ianm8/iqSDR40/README.md

# iqSDR40
A small software defined transceiver for 40M using the phasing method of image rejection.

### Features
* Pi Pico 2 (RP2350)
* TCXO frequency stability
* PCM1808 24 bit ADC
* Direct conversion quadrature phasing image rejection
* Floating point DSP
* LSB, USB and CW
* 30 KHz spectrum display
* Effective AGC and S meter
* Mostly 1206 SM parts
* 100mm X 80mm PCB

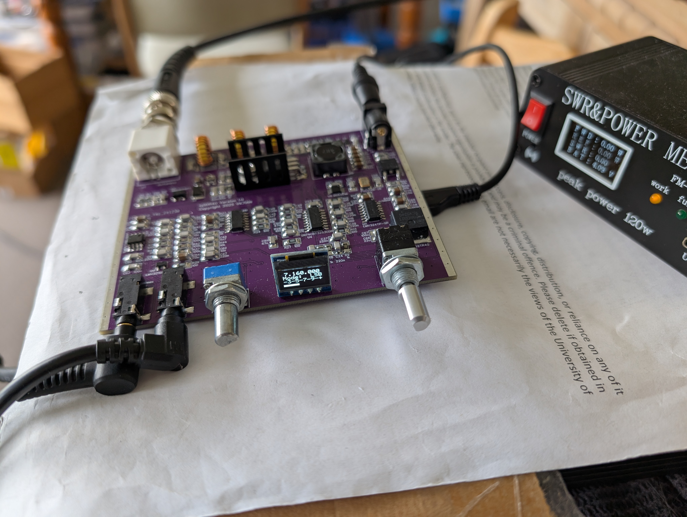
[picture p1: docs/iqSDR40-Complete-1.jpg]
