ianm8/iqSDR40/src/README.md

 ## Build
 *  Board: Pi Pico 2
 *  Flash 4MB (Sketch: 4032KB, FS: 64KB)
 *  CPU Speed: 240Mhz
 *  Optimize: -O3
 *  USB Stack: No USB

## Some history
 * Version 0.9.240 code cleanup
 * Version 1.0.240 CW paddle support and bug fixes
 * Version 1.1.240 bug fixes
 * Version 1.2.240 delay mic level to settle
 * Version 1.3.240 update filters
 * Version 2.0.240 CESSB
 * Version 2.1.240 mic gain
 * Version 2.2.240 RX bandwidth
 * Version 2.3.240 remove spectrum hack
 * Version 2.4.240 TX bandwidth
