ianm8/iqSDR40/docs/BOM_iqSDR40_2025-04-01.csv

ID | Name | Designator | Footprint | Quantity | Manufacturer Part | Manufacturer | Supplier | Supplier Part
1 | 330p | C1,C3,C8,C21 | 1206 | 4
2 | 220p | C2 | 1206 | 1
3 | 100p | C4 | 1206 | 1
4 | 510p | C5,C44,C45 | 1206 | 3
5 | 820p | C6,C7,C53 | 1206 | 3
6 | 100n | C9,C15,C17,C18,C20,C22,C23,C28,C30,C32,C34,C58,C60,C63,C64,C67,C68,C71,C72 | 1206 | 19
7 | 22u | C10,C11,C12,C13,C14,C16,C29,C31,C33,C35,C46,C54,C65,C66,C69,C70 | 1206 | 16
8 | 10n | C19,C26,C27,C49,C50,C51,C52,C57,C59,C62,C73 | 1206 | 11
9 | 220n | C24,C25,C36,C37,C38,C39,C47,C48,C56,C61 | 1206 | 10
10 | 47n | C40,C41,C42,C43,C55 | 1206 | 5
11 | 1N4148W-7-F | D1,D2 | SOD-123_L2.8-W1.8-LS3.7-RD | 2 | 1N4148W-7-F |  | Mouser
12 | SS14 | D3 | SMA_L4.4-W2.8-LS5.4-RD | 1 | SS14 | MDD | Mouser
13 | Antenna | J1 | BNC_PCB | 1 | 73137-5015 | Molex | Mouser | 538-73137-5015
14 | Mic | J2 | CUI_SJ-3524-SMT | 1 |  |  |  | SJ-3524-SMT
15 | Phones | J3 | CUI_SJ-3524-SMT | 1 |  |  | Mouser | SJ-3524-SMT
16 | Power | J4 | DC-072-165A | 1 | PJ-002AH | Same Sky | Mouser
17 | OLED-SSD1306 | J5 | HDR-M-2.54_1X4 | 1
18 | 1u2 | L1,L2,L3 | T37-6 | 3
19 | 1u | L4,L5 | 120608 | 2 | MCQ1V3216-1R0-R | Eaton Electronics | Mouser | 704-MCQ1V3216-1R0-R
20 | PFL4514-153MEC | L6 | PFL4514-SM | 1 | PFL4514 | Coilcraft |  | PFL4514
21 | PZT2222 | Q1 | SOT-223_L6.5-W3.5-P2.30-LS7.0-BR | 1 | PZT2222AT1G | ON Semicon | Mouser
22 | RD16HHF1 | Q2 | TO220 | 1 | RD16HHF1 |  |  | Heatsink: 567-274-2AB
23 | FQD11P06TM | Q3 | DPAK-3_L6.6-W6.1-P2.28-LS9.9-BR | 1 | FQD11P06TM | ON Semiconductor | Mouser
24 | 1k | R1,R2,R8,R9,R16,R17,R18,R19,R30,R31,R34,R36 | 1206 | 12 | ?
25 | 10k | R3,R21,R22,R44,R45,R50,R51 | 1206 | 7 | ?
26 | 100 | R4,R5,R7,R10,R12,R13,R14,R15,R23,R24,R25,R26,R27,R28,R29 | 1206 | 15 | ?
27 | 10 | R6,R11,R20 | 1206 | 3 | ?
28 | 100k | R32,R35,R37,R39,R41,R42 | 1206 | 6 | ?
29 | 2k | R33,R38,R40,R43,R46,R47,R48 | 1206 | 7 | ?
30 | 10/500mW | R49 | 1206 | 1 | ? |  |  | 352210RJT
31 | PEC09-SWITCH-T | SW1 | PEC09-SWITCH-T | 1 | PEC09-2315K-T0015 or PEC09-2320F-T0015 | Bourns | Digi-Key | 118-PEC09-2315K-T0015-ND
32 | SRF1260-4R7Y | T1 | SRF1260-4R7Y | 1 | SRF1260-4R7Y | Bourns | Mouser | 652-SRF1260-4R7Y
33 | PA4339.501 | T2 | PA4339.501NLT FOOTPRINT | 1 | PA4339.501NLT | Pulse Electronics Power | Mouser | PA4339.501NLT
34 | TLS850B0TE V50 | U1 | PG-TO252-5_L6.5-W6.3-P1.14-LS10.0-BR | 1 | TLS850B0TE V50 | Infineon(英飞凌) | Mouser
35 | MMG3H21NT1 | U2 | SOT-89-3_L4.5-W2.5-P1.50-LS4.2-BR | 1 | MMG3H21NT1 | NXP | Mouser
36 | PCM1808PW | U3 | TSSOP-14_L5.0-W4.4-P0.65-LS6.4-BL | 1 | PCM1808PW | TI(德州仪器) | Mouser
37 | SN74CBT3253CDR | U4 | SOIC-16_L9.9-W3.9-P1.27-LS6.0-BL | 1 | SN74CBT3253PWR | Texas Instruments | Mouser
38 | MS5351M | U5 | MSOP-10_L3.0-W3.0-P0.50-LS5.0-BL | 1 | MS5351M | 杭州瑞盟 | LCSC | C1509083
39 | FOX914B-26 | U6 | FOX924B | 1 | FOX924B-25 | Fox | Mouser | 559-FOX924B-25
40 | LMV321SN3T1G | U9 | TSOP-5_L3.0-W1.5-P0.95-BL | 1 | LMV321SN3T1G |  | Mouser
41 | LM4875MX/NOPB | U10 | SOIC-8 | 1 | LM4875MX/NOPB | TI | Mouser
42 | Raspberry Pi Pico 2 Castellated | U11 | PI_PICO_RP2040 | 1 | Pi Pico 2 | Raspberry Pi Foundation | Raspberry Pi | Pi Pico 2
43 | MC7805CD2TR4G | U12 | TO-263-2_L10.0-W9.1-P5.08-LS15.2-TL | 1 | MC7805CD2TR4G | onsemi | Mouser | 863-MC7805CD2TR4G
44 | 1k | VR1 | 35WR1KLFTR | 1 |  |  |  | 35WR1KLFTR
45 | 10k | VR2 | BOURNS_PTD901_1GANG | 1 | PTD901-1015K-B103‎ | Bourns | Mouser | PTD901-1015K-B103‎
46 | LMV324TP-SR | U7 | SOIC-14_L8.7-W3.9-P1.27-LS6.0-BL | 1 | 3PEAK | LMV324TP-SR | Mouser | C90298
47 | TL974ID | U8 | SOIC-14_L8.7-W3.9-P1.27-LS6.0-BL | 1 | TL974ID | TI(德州仪器) | Mouser | C1347110
