ianm8/iqSDR40/docs/Schematic_iqSDR40_2025-04-01.pdf

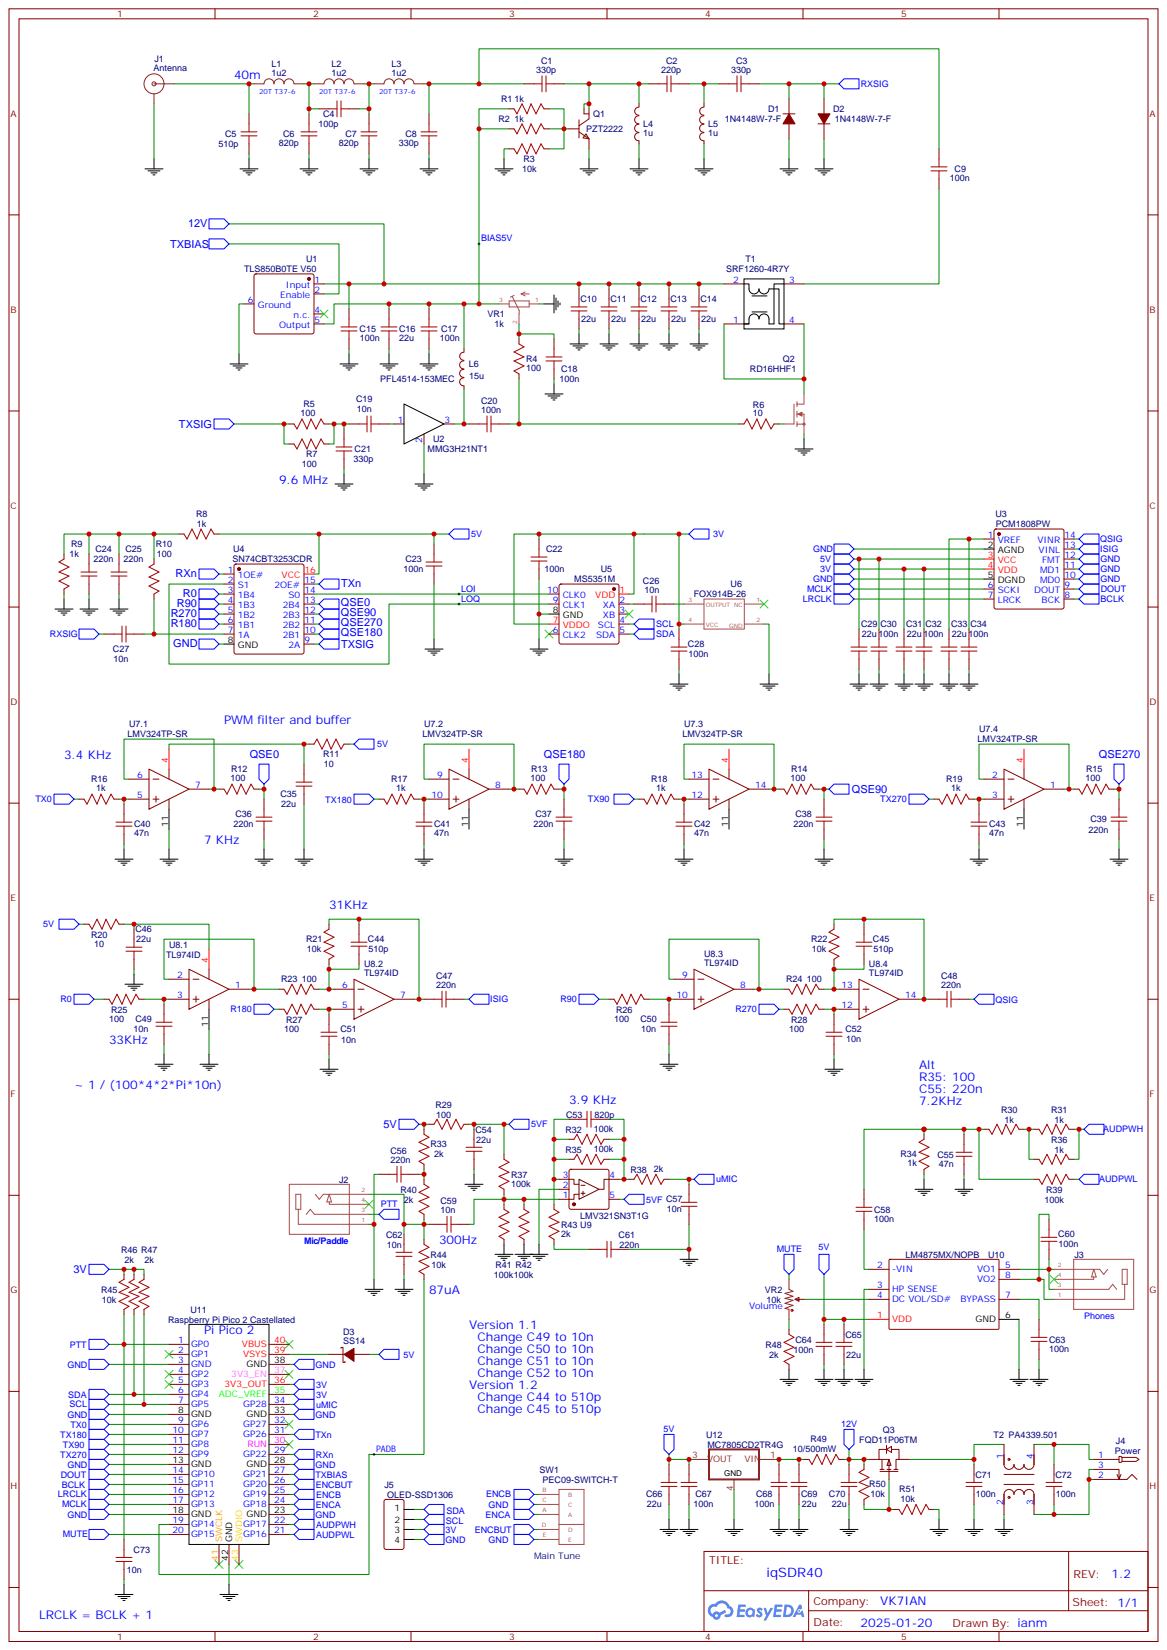
[picture p2: page 1]

PWM filter and buffer

Raspberry Pi Pico 2 Castellated
