ianm8/iqSDR40/src/filter.h

#ifndef FILTER_H
#define FILTER_H

#define JNR_FILTER_LENGTH 8
#define BANDWIDTH_2200 1u
#define BANDWIDTH_2400 2u
#define BANDWIDTH_2600 3u
#define BANDWIDTH_2800 4u
#define BANDWIDTH_3000 5u
#define FIR_LENGTH 256
#define MA_FILTER_LENGTH 8
#define MA_FILTER_MASK (MA_FILTER_LENGTH-1)
#define __mac_tap(_h) acc += (_h)*x[i++]
#define __mac_zap(_h) i++

namespace FILTER
{
  static const float __not_in_flash_func(ma4i)(const float v1)
  {
    static float delay1[MA_FILTER_LENGTH] = { 0 };
    static float delay2[MA_FILTER_LENGTH] = { 0 };
    static float delay3[MA_FILTER_LENGTH] = { 0 };
    static float delay4[MA_FILTER_LENGTH] = { 0 };
    static float sum1 = 0;
    static float sum2 = 0;
    static float sum3 = 0;
    static float sum4 = 0;
    static uint8_t p = 0;
    sum1 = sum1 - delay1[p] + v1;
    delay1[p] = v1;
    const float v2 = sum1 / (float)MA_FILTER_LENGTH;
    sum2 = sum2 - delay2[p] + v2;
    delay2[p] = v2;
    const float v3 = sum2 / (float)MA_FILTER_LENGTH;
    sum3 = sum3 - delay3[p] + v3;
    delay3[p] = v3;
    const float v4 = sum3 / (float)MA_FILTER_LENGTH;
    sum4 = sum4 - delay4[p] + v4;
    delay4[p] = v4;
    p++;
    p &= MA_FILTER_MASK;
    return sum4 / (float)MA_FILTER_LENGTH;
  }

  static const float __not_in_flash_func(ma4q)(const float v1)
  {
    static float delay1[MA_FILTER_LENGTH] = { 0 };
    static float delay2[MA_FILTER_LENGTH] = { 0 };
    static float delay3[MA_FILTER_LENGTH] = { 0 };
    static float delay4[MA_FILTER_LENGTH] = { 0 };
    static float sum1 = 0;
    static float sum2 = 0;
    static float sum3 = 0;
    static float sum4 = 0;
    static uint8_t p = 0;
    sum1 = sum1 - delay1[p] + v1;
    delay1[p] = v1;
    const float v2 = sum1 / (float)MA_FILTER_LENGTH;
    sum2 = sum2 - delay2[p] + v2;
    delay2[p] = v2;
    const float v3 = sum2 / (float)MA_FILTER_LENGTH;
    sum3 = sum3 - delay3[p] + v3;
    delay3[p] = v3;
    const float v4 = sum3 / (float)MA_FILTER_LENGTH;
    sum4 = sum4 - delay4[p] + v4;
    delay4[p] = v4;
    p++;
    p &= MA_FILTER_MASK;
    return sum4 / (float)MA_FILTER_LENGTH;
  }

  static float __not_in_flash_func(dcf)(const float in)
  {
    // single pole IIR high-pass filter
    //static const float k = 0.004f; // <100Hz
    //static const float k = 0.01f; // ~100Hz
    //static const float k = 0.1f; // ~300Hz
    static const float k = 0.05f; // ~200Hz
    static float s = 0;
    static float x1 = 0;
    static float y1 = 0;
    s -= x1;
    x1 = in;
    s += x1 - y1 * k;
    return (y1 = s);
  }

  static float __not_in_flash_func(dc1f)(const float in)
  {
    static const float k = 0.05f;
    static float s = 0;
    static float x1 = 0;
    static float y1 = 0;
    s -= x1;
    x1 = in;
    s += x1 - y1 * k;
    return (y1 = s);
  }

  static float __not_in_flash_func(dc2f)(const float in)
  {
    static const float k = 0.05f;
    static float s = 0;
    static float x1 = 0;
    static float y1 = 0;
    s -= x1;
    x1 = in;
    s += x1 - y1 * k;
    return (y1 = s);
  }

  static const float __not_in_flash_func(fap1f)(const float s)
  {
    // all pass 84 @ 31250
    // all pass 607 @ 31250
    // all pass 2539 @ 31250
    static const float k1 = 0.98325f;
    static const float k2 = 0.88497f;
    static const float k3 = 0.59331f;
    static float x1 = 0.0f;
    static float y1 = 0.0f;
    static float x2 = 0.0f;
    static float y2 = 0.0f;
    static float x3 = 0.0f;
    static float y3 = 0.0f;
    y1 = (k1 * (s + y1)) - x1;
    x1 = s;
    y2 = (k2 * (y1 + y2)) - x2;
    x2 = y1;
    y3 = (k3 * (y2 + y3)) - x3;
    x3 = y2;
    return y3;
  }

  static const float __not_in_flash_func(fap2f)(const float s)
  {
    // all pass 8628 @ 31250
    // all pass 1200 @ 31250
    // all pass 287 @ 31250
    static const float k1 = 0.07102f;
    static const float k2 = 0.78470f;
    static const float k3 = 0.94391f;
    static float x1 = 0.0f;
    static float y1 = 0.0f;
    static float x2 = 0.0f;
    static float y2 = 0.0f;
    static float x3 = 0.0f;
    static float y3 = 0.0f;
    y1 = (k1 * (s + y1)) - x1;
    x1 = s;
    y2 = (k2 * (y1 + y2)) - x2;
    x2 = y1;
    y3 = (k3 * (y2 + y3)) - x3;
    x3 = y2;
    return y3;
  }

  static const float __not_in_flash_func(lpf_2200f_rx)(const float sample)
  {
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
  {
    static float element[JNR_FILTER_LENGTH] = {0.0f};
    static uint8_t p = 0;
    static float sum = 0.0f;
    sum = sum - element[p] + v;
    element[p++] = v;
    p &= (JNR_FILTER_LENGTH-1);
    return sum / ((float)JNR_FILTER_LENGTH);
  }

  static const float __not_in_flash_func(jnr)(const float s,const uint32_t level)
  {
    // just noise reduction (not dynamic)
    switch (level)
    {
      case 1: return jnr_maf1(s);
      case 2: return jnr_maf2(FILTER::jnr_maf1(s));
      case 3: return jnr_maf4(FILTER::jnr_maf3(FILTER::jnr_maf2(FILTER::jnr_maf1(s))));
    }
    return s;
  }

  typedef const float (*bw_func_t)(const float);
  static const bw_func_t bwf[6] =
  {
    lpf_2400f_rx,
    lpf_2200f_rx,
    lpf_2400f_rx,
    lpf_2600f_rx,
    lpf_2800f_rx,
    lpf_3000f_rx
  };
}

#endif
