ianm8/iqSDR40/src/spectrum.h

#ifndef SPECTRUM_H
#define SPECTRUM_H

#define N_WAVE      1024    /* full length of sinewave[] */
#define LOG2_N_WAVE 10      /* log2(N_WAVE) */

namespace spectrum
{
  static const int16_t Sinewave[N_WAVE-N_WAVE/4] =
  {
       0,    201,    402,    603,    804,   1005,   1206,   1406,
    1607,   1808,   2009,   2209,   2410,   2610,   2811,   3011,
    3211,   3411,   3611,   3811,   4011,   4210,   4409,   4608,
    4807,   5006,   5205,   5403,   5601,   5799,   5997,   6195,
    6392,   6589,   6786,   6982,   7179,   7375,   7571,   7766,
    7961,   8156,   8351,   8545,   8739,   8932,   9126,   9319,
    9511,   9703,   9895,  10087,  10278,  10469,  10659,  10849,
    11038,  11227,  11416,  11604,  11792,  11980,  12166,  12353,
    12539,  12724,  12909,  13094,  13278,  13462,  13645,  13827,
    14009,  14191,  14372,  14552,  14732,  14911,  15090,  15268,
    15446,  15623,  15799,  15975,  16150,  16325,  16499,  16672,
    16845,  17017,  17189,  17360,  17530,  17699,  17868,  18036,
    18204,  18371,  18537,  18702,  18867,  19031,  19194,  19357,
    19519,  19680,  19840,  20000,  20159,  20317,  20474,  20631,
    20787,  20942,  21096,  21249,  21402,  21554,  21705,  21855,
    22004,  22153,  22301,  22448,  22594,  22739,  22883,  23027,
    23169,  23311,  23452,  23592,  23731,  23869,  24006,  24143,
    24278,  24413,  24546,  24679,  24811,  24942,  25072,  25201,
    25329,  25456,  25582,  25707,  25831,  25954,  26077,  26198,
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
    26411, 26491, 26570, 26648, 26727, 26805, 26882, 26959, 27036, 27112, 27188,
    27263, 27338, 27413, 27487, 27561, 27634, 27707, 27780, 27852, 27923, 27995,
    28065, 28136, 28206, 28275, 28344, 28412, 28481, 28548, 28615, 28682, 28748,
    28814, 28879, 28944, 29009, 29073, 29136, 29199, 29261, 29323, 29385, 29446,
    29506, 29566, 29626, 29685, 29743, 29801, 29859, 29916, 29972, 30028, 30083,
    30138, 30193, 30247, 30300, 30353, 30405, 30457, 30508, 30559, 30609, 30659,
    30708, 30756, 30804, 30852, 30899, 30945, 30991, 31036, 31081, 31125, 31169,
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
  };

  static const uint8_t log16(const uint32_t l)
  {
    // return a 4 bit log value
    if (l>1023) return 0x0fu;
    static const uint8_t logtab16[1024] = 
    {
      0u,
      0u,
      0u,
      0u,
      0u,
      0u,
      0u,
      1u,
      1u,
      2u,
      2u,
      3u,
      3u,
      3u,
      3u,
      4u,
      4u,
      4u,
      4u,
      5u,
      5u,
      5u,
      5u,
      5u,
      6u,
      6u,
      6u,
      6u,
      6u,
      6u,
      6u,
      7u,
      7u,
      7u,
      7u,
      7u,
      7u,
      7u,
      7u,
      7u,
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
    };
    return logtab16[l];
  }

  /*
    FIX_MPY() - fixed-point multiplication & scaling.
    Substitute inline assembly for hardware-specific
    optimization suited to a particluar DSP processor.
    Scaling ensures that result remains 16-bit.
  */
  inline int16_t FIX_MPY(int16_t a, int16_t b)
  {
    /* shift right one less bit (i.e. 15-1) */
    int32_t c = ((int32_t)a * (int32_t)b) >> 14;
    /* last bit shifted out = rounding-bit */
    b = c & 0x01;
    /* last shift + rounding bit */
    a = (c >> 1) + b;
    return a;
  }

  /*
    fix_fft() - perform forward/inverse fast Fourier transform.
    fr[n],fi[n] are real and imaginary arrays, both INPUT AND
    RESULT (in-place FFT), with 0 <= n < 2**m; set inverse to
    0 for forward transform (FFT), or 1 for iFFT.
  */
  static int32_t fix_fft(int16_t fr[], int16_t fi[], int16_t m, const bool inverse=false)
  {
    int32_t mr, nn, i, j, l, k, istep, n, scale, shift;
    int16_t qr, qi, tr, ti, wr, wi;

    n = 1 << m;

    /* max FFT size = N_WAVE */
    if (n > N_WAVE)
      return -1;

    mr = 0;
    nn = n - 1;
    scale = 0;

    /* decimation in time - re-order data */
    for (m=1; m<=nn; ++m)
    {
      l = n;
      do
      {
        l >>= 1;
      } while (mr+l > nn);
      mr = (mr & (l-1)) + l;

      if (mr <= m)
        continue;
      tr = fr[m];
      fr[m] = fr[mr];
      fr[mr] = tr;
      ti = fi[m];
      fi[m] = fi[mr];
      fi[mr] = ti;
    }

    l = 1;
    k = LOG2_N_WAVE-1;
    while (l < n)
    {
      if (inverse)
      {
        /* variable scaling, depending upon data */
        shift = 0;
        for (i=0; i<n; ++i)
        {
          j = fr[i];
          if (j < 0)
            j = -j;
          m = fi[i];
          if (m < 0)
            m = -m;
          if (j > 16383 || m > 16383)
          {
            shift = 1;
            break;
          }
        }
        if (shift) ++scale;
      }
      else
      {
        /*
          fixed scaling, for proper normalization --
          there will be log2(n) passes, so this results
          in an overall factor of 1/n, distributed to
          maximize arithmetic accuracy.
        */
        shift = 1;
      }
      /*
        it may not be obvious, but the shift will be
        performed on each data point exactly once,
        during this pass.
      */
      istep = l << 1;
      for (m=0; m<l; ++m)
      {
        j = m << k;
        /* 0 <= j < N_WAVE/2 */
        wr =  Sinewave[j+N_WAVE/4];
        wi = -Sinewave[j];
        if (inverse)
          wi = -wi;
        if (shift)
        {
          wr >>= 1;
          wi >>= 1;
        }
        for (i=m; i<n; i+=istep)
        {
          j = i + l;
          tr = FIX_MPY(wr,fr[j]) - FIX_MPY(wi,fi[j]);
          ti = FIX_MPY(wr,fi[j]) + FIX_MPY(wi,fr[j]);
          qr = fr[i];
          qi = fi[i];
          if (shift)
          {
            qr >>= 1;
            qi >>= 1;
          }
          fr[j] = qr - tr;
          fi[j] = qi - ti;
          fr[i] = qr + tr;
          fi[i] = qi + ti;
        }
      }
      --k;
      l = istep;
    }
    return scale;
  }

  void process(int16_t ii[], int16_t qq[],uint8_t mag[])
  {
    int16_t re[N_WAVE] = { 0 };
    int16_t im[N_WAVE] = { 0 };

    // DC removal
    // (get the average and subtract from all samples)
    int32_t dc1 = 0;
    int32_t dc2 = 0;
    for (int32_t i=0;i<N_WAVE;i++)
    {
      dc1 += ii[i];
      dc2 += qq[i];
    }
    dc1 >>= 10;
    dc2 >>= 10;

    // Hann window
    for (uint32_t i = 0; i < N_WAVE; i++)
    {
      const int32_t value_re = (int32_t)ii[i] - dc1;
      const int32_t value_im = (int32_t)qq[i] - dc2;
      const int32_t w_re = value_re * (int32_t)window_hanning_1024[i];
      const int32_t w_im = value_im * (int32_t)window_hanning_1024[i];
      re[i] = (int16_t)(w_re >> 15);
      im[i] = (int16_t)(w_im >> 15);
    }

    // forward, complex FFT
    fix_fft(re, im, LOG2_N_WAVE);

    // magnitude estimate
    uint32_t magnitude[N_WAVE] = {0};
    for (uint32_t i = 0; i < N_WAVE; i++)
    {
      // magnitude estimate
      const uint32_t m = (uint32_t)abs(re[i]);
      const uint32_t n = (uint32_t)abs(im[i]);
      magnitude[i] = ((15 * max(m, n))>>4) + ((15 * min(m, n)) >> 5);
    }

    // reverse the frequency bins so that they are in order
    // and compensate for analog amplitude droop
    for (int32_t i=0,j=511;i<512;i++,j--)
    {
      uint32_t mag_adjusted = magnitude[j];
      mag[i] = log16(mag_adjusted);
    }
    for (int32_t i=512,j=1023;i<1024;i++,j--)
    {
      uint32_t mag_adjusted = magnitude[j];
      mag[i] = log16(mag_adjusted);
    }
  }
}

#endif
