ianm8/iqSDR40/(commit log)

2025-02-27 Gerber front and back
2025-03-14 Fix BOM CSV formatting
    [BOM_iqSDR40_2025-03-14 .csv, PickAndPlace_iqSDR40_2025-03-14 .csv]
2025-03-31 Version 1.2
    [BOM_iqSDR40_2025-03-14 .csv]
